john-denny/Speaker-PCB/review/2026-10-24/inner-3v3-plane.png

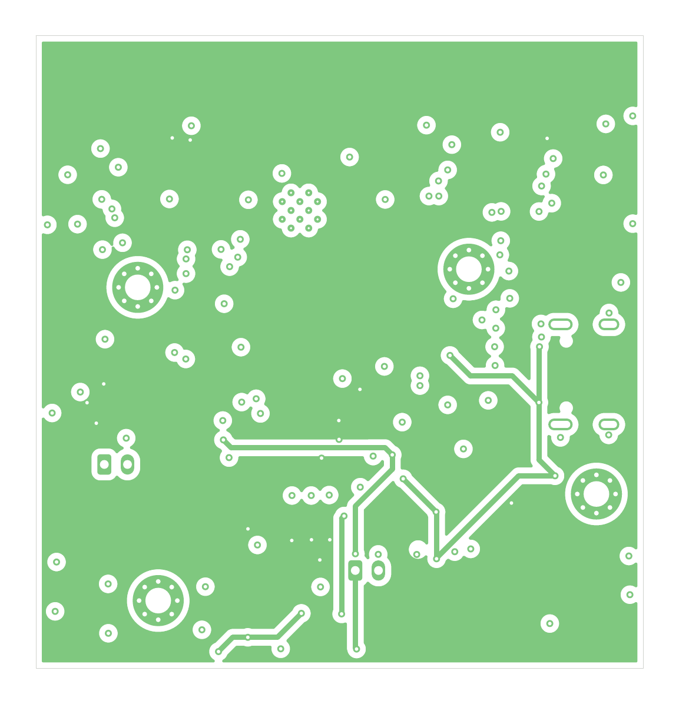
review/2026-10-24/inner-3v3-plane.png
