john-denny/Speaker-PCB/review/2026-10-24/inner-ground-plane.png

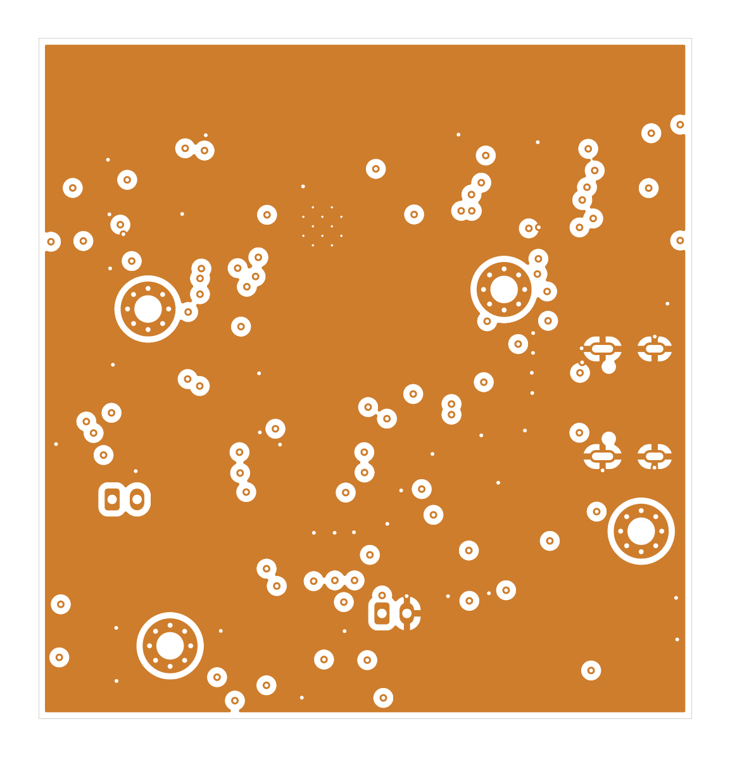
review/2026-10-24/inner-ground-plane.png
