john-denny/Speaker-PCB/review/2026-10-24/top-copper.png

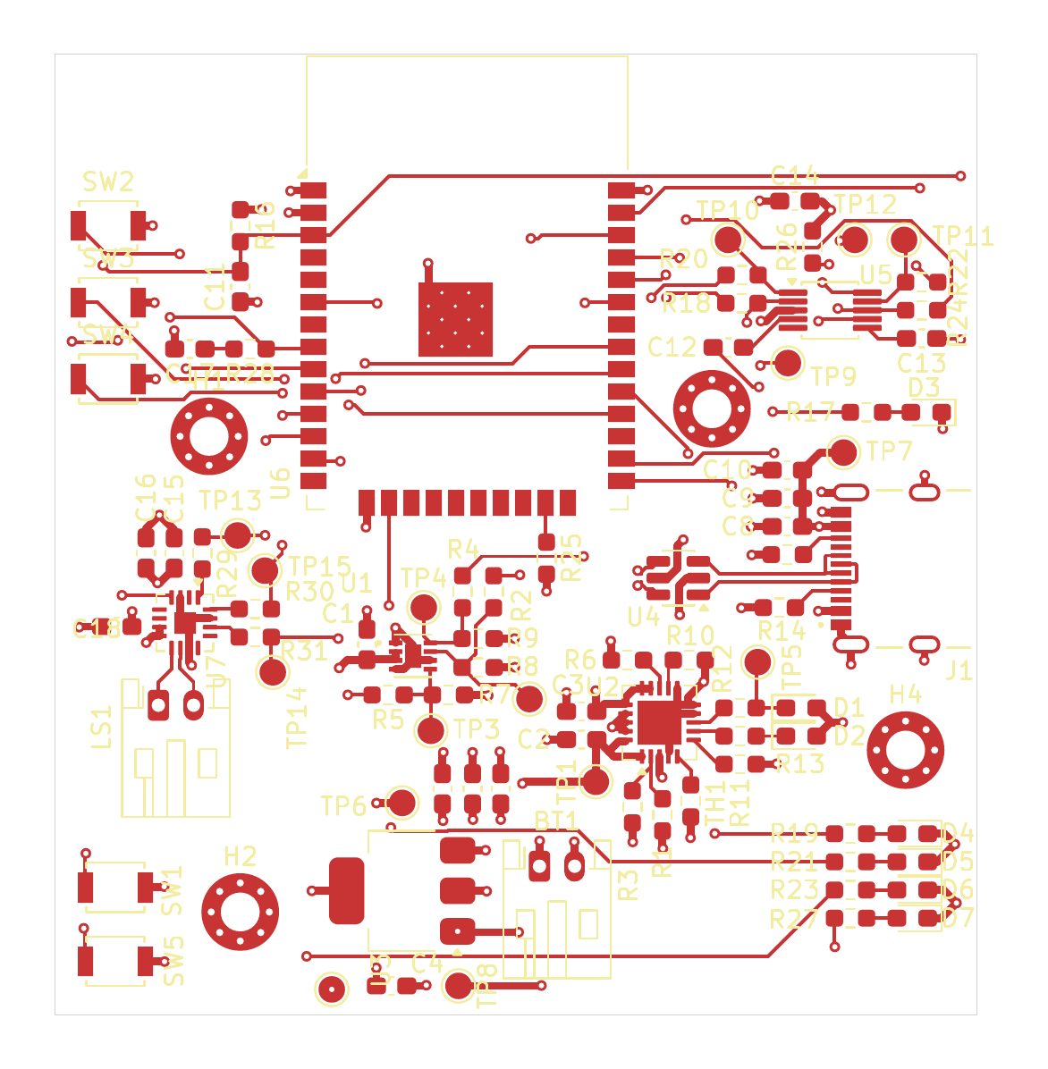
review/2026-10-24/top-copper.png
