john-denny/Speaker-PCB/Speaker.kicad_pcb

## KiCad design Speaker.kicad_pcb (2026-10-24)

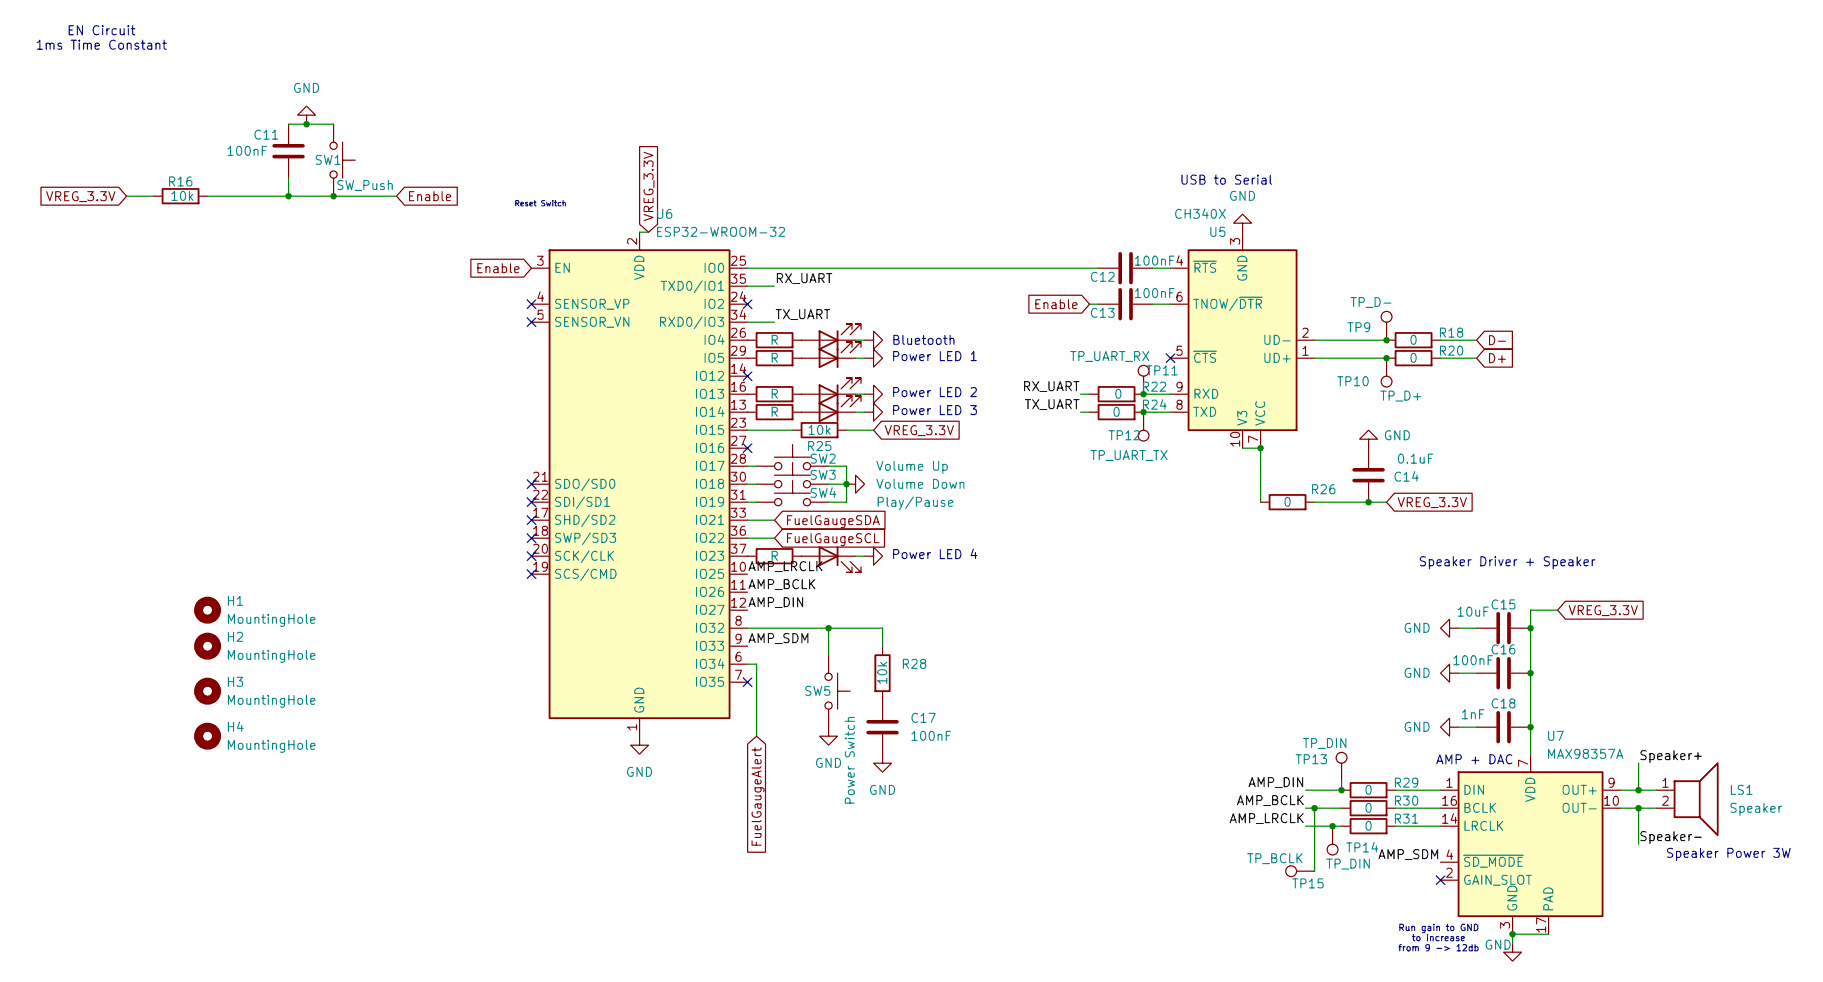
[picture p5: schematic mcu.kicad_sch]

Parts:
C11, C12, C13, C16, C17: 100nF; C_0603_1608Metric_Pad1.08x0.95mm_HandSolder
C14: 0.1uF; C_0603_1608Metric_Pad1.08x0.95mm_HandSolder
C15: 10uF; C_0603_1608Metric_Pad1.08x0.95mm_HandSolder
C18: 1nF; C_0603_1608Metric_Pad1.08x0.95mm_HandSolder
D3, D4, D5, D6, D7: LED; LED_0603_1608Metric_Pad1.05x0.95mm_HandSolder
H1, H2, H3, H4: MountingHole; MountingHole_2.2mm_M2_Pad_Via
LS1: Speaker; JST_PH_S2B-PH-K_1x02_P2.00mm_Horizontal
R16, R25, R28: 10k; R_0603_1608Metric_Pad0.98x0.95mm_HandSolder
R17, R19, R21, R23, R27: R; R_0603_1608Metric_Pad0.98x0.95mm_HandSolder
R18, R20, R22, R24, R26, R29, R30, R31: 0; R_0603_1608Metric_Pad0.98x0.95mm_HandSolder
SW1: SW_Push; SW_SPST_B3U-1000P
SW2: Volume Up; SW_SPST_B3U-1000P
SW3: Volume Down; SW_SPST_B3U-1000P
SW4: Play/Pause; SW_SPST_B3U-1000P
SW5: Power Switch; SW_SPST_B3U-1000P
TP9: TP_D-; TestPoint_Pad_D1.5mm
TP10: TP_D+; TestPoint_Pad_D1.5mm
TP11: TP_UART_RX; TestPoint_Pad_D1.5mm
TP12: TP_UART_TX; TestPoint_Pad_D1.5mm
TP13, TP14: TP_DIN; TestPoint_Pad_D1.5mm
TP15: TP_BCLK; TestPoint_Pad_D1.5mm
U5: CH340X; MSOP-10_3x3mm_P0.5mm
U6: ESP32-WROOM-32
U7: MAX98357A; TQFN-16-1EP_3x3mm_P0.5mm_EP1.23x1.23mm

Connections:
/MCU/AMP_BCLK: R30.1, TP15.1, U6.11 (IO26)
/MCU/AMP_DIN: R29.1, TP13.1, U6.12 (IO27)
/MCU/AMP_LRCLK: R31.1, TP14.1, U6.10 (IO25)
/MCU/AMP_SDM: U6.9 (IO33), U7.4 (~SD_MODE)
/MCU/RX_UART: R22.1, U6.35 (TXD0/IO1)
/MCU/Speaker+: LS1.1, U7.9 (OUT+)
/MCU/Speaker-: LS1.2, U7.10 (OUT-)
/MCU/TX_UART: R24.1, U6.34 (RXD0/IO3)
D+: R20.2; also elsewhere on the board
D-: R18.2; also elsewhere on the board
Enable: C11.2, C13.1, R16.2, SW1.2, U6.3 (EN)
FuelGaugeAlert: U6.6 (IO34); also elsewhere on the board
FuelGaugeSCL: U6.36 (IO22); also elsewhere on the board
FuelGaugeSDA: U6.33 (IO21); also elsewhere on the board
GND: C11.1, C14.1, C15.1, C16.1, C17.2, C18.1, D3.1 (K), D4.1 (K), D5.1 (K), D6.1 (K), D7.1 (K), SW1.1, SW2.2, SW3.2, SW4.2, SW5.2, U5.3 (GND), U6.1 (GND), U6.15 (GND), U6.38 (GND), U6.39 (GND), U7.3 (GND), U7.11 (GND), U7.15 (GND), U7.17 (PAD); also elsewhere on the board
unnamed: C17.1, R28.2
unnamed: D3.2 (A), R17.2
unnamed: D4.2 (A), R19.2
unnamed: D5.2 (A), R21.2
unnamed: D6.2 (A), R23.2
unnamed: D7.2 (A), R27.2
unnamed: R22.2, TP11.1, U5.9 (RXD)
unnamed: C13.2, U5.6 (TNOW/~DTR)
unnamed: R24.2, TP12.1, U5.8 (TXD)
unnamed: R20.1, TP10.1, U5.1 (UD+)
unnamed: R18.1, TP9.1, U5.2 (UD-)
unnamed: R26.1, U5.7 (VCC), U5.10 (V3)
unnamed: C12.2, U5.4 (~RTS)
unnamed: C12.1, U6.25 (IO0)
unnamed: R17.1, U6.26 (IO4)
unnamed: R19.1, U6.29 (IO5)
unnamed: R21.1, U6.16 (IO13)
unnamed: R23.1, U6.13 (IO14)
unnamed: R25.1, U6.23 (IO15)
unnamed: SW2.1, U6.28 (IO17)
unnamed: SW3.1, U6.30 (IO18)
unnamed: SW4.1, U6.31 (IO19)
unnamed: R27.1, U6.37 (IO23)
unnamed: R28.1, SW5.1, U6.8 (IO32)
unnamed: R30.2, U7.16 (BCLK)
unnamed: R29.2, U7.1 (DIN)
unnamed: R31.2, U7.14 (LRCLK)
VREG_3.3V: C14.2, C15.2, C16.2, C18.2, R16.1, R25.2, R26.2, U6.2 (VDD), U7.7 (VDD), U7.8 (VDD); also elsewhere on the board

Notes on the sheet:
AMP + DAC
Reset Switch
Power LED 4
Bluetooth
EN Circuit 1ms Time Constant
Speaker Driver + Speaker
Power LED 3
USB to Serial
Speaker Power 3W
Run gain to GND to increase from 9 -> 12db
Power LED 2
Power LED 1

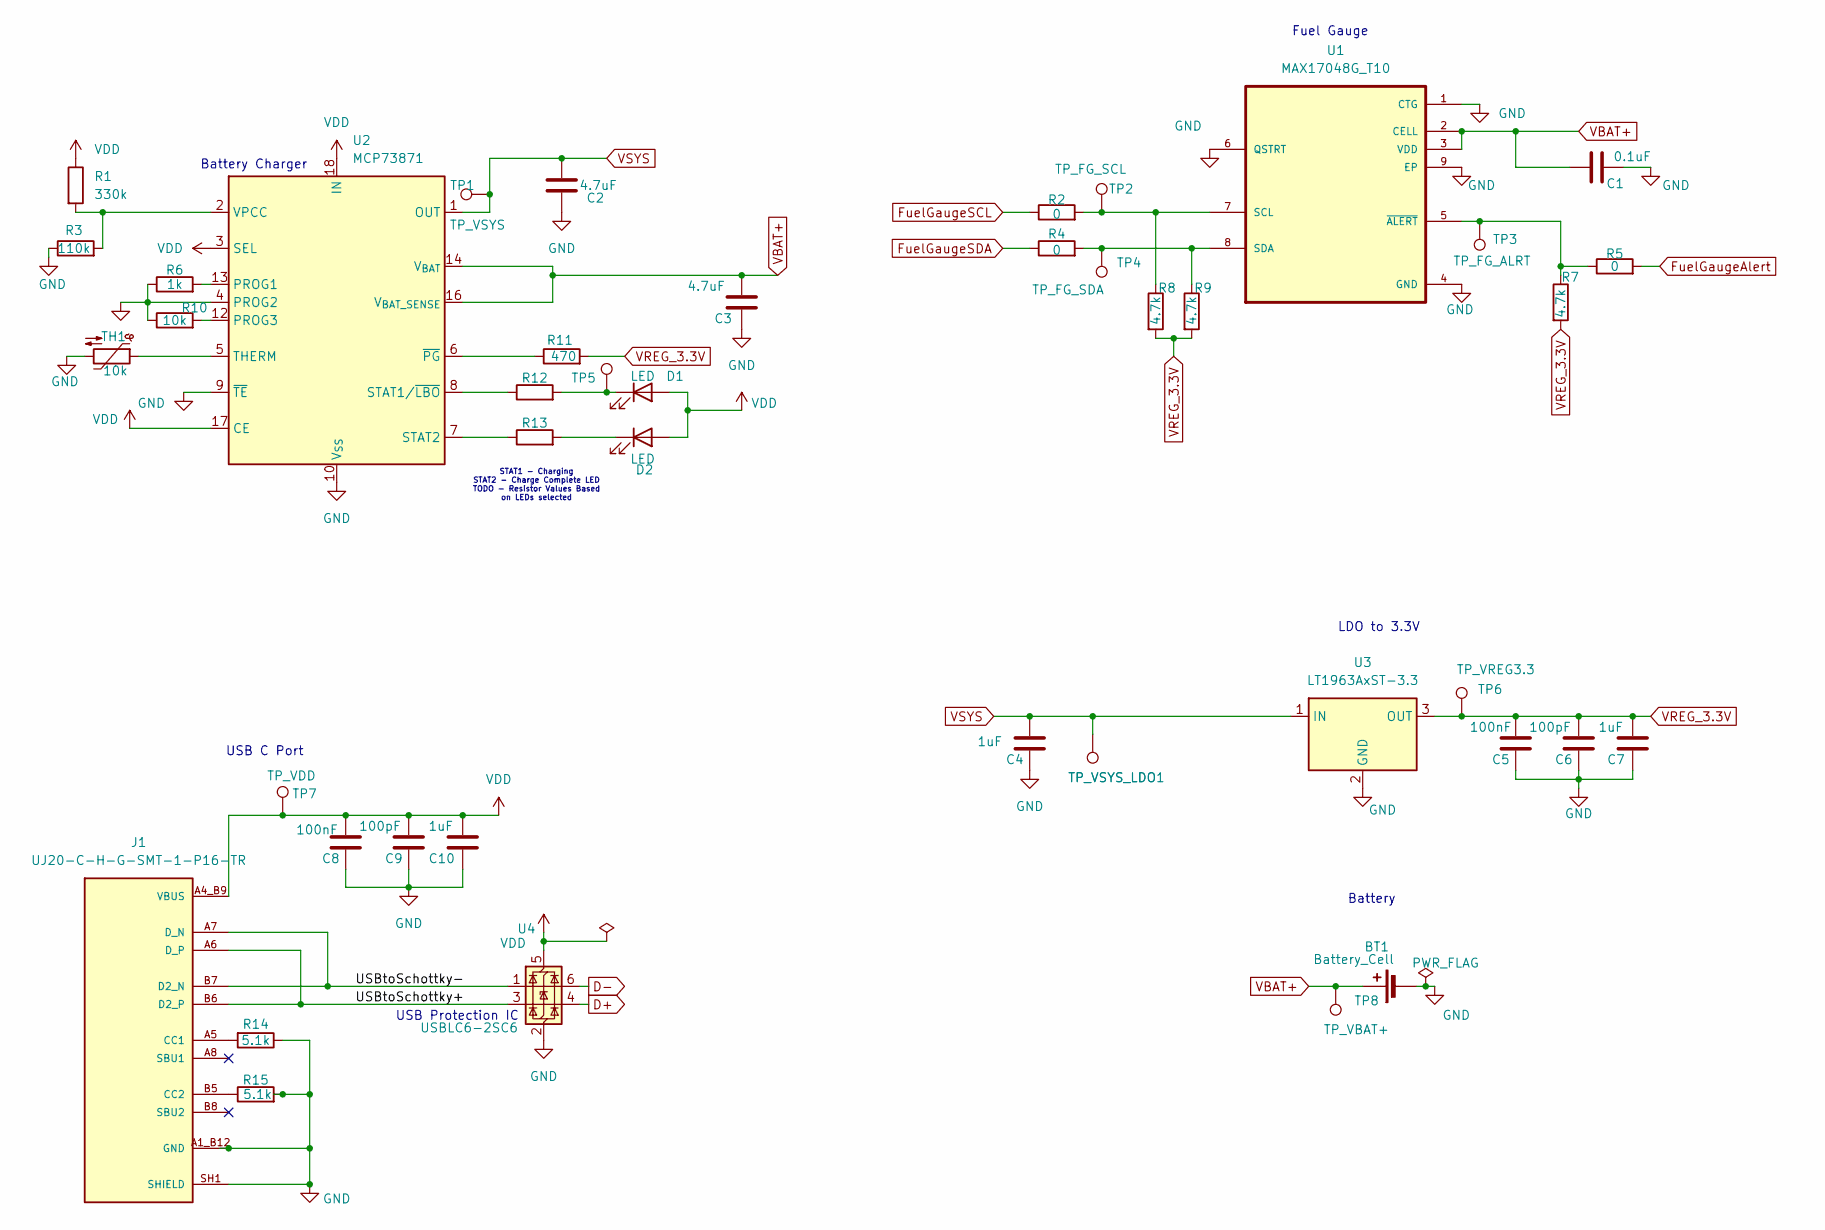
[picture p6: schematic power.kicad_sch]

Parts:
BT1: Battery_Cell; JST_PH_S2B-PH-K_1x02_P2.00mm_Horizontal
C1: 0.1uF; C_0603_1608Metric_Pad1.08x0.95mm_HandSolder
C2, C3: 4.7uF; C_0603_1608Metric_Pad1.08x0.95mm_HandSolder
C4, C7, C10: 1uF; C_0603_1608Metric_Pad1.08x0.95mm_HandSolder
C5, C8: 100nF; C_0603_1608Metric_Pad1.08x0.95mm_HandSolder
C6, C9: 100pF; C_0603_1608Metric_Pad1.08x0.95mm_HandSolder
D1, D2: LED; LED_0603_1608Metric_Pad1.05x0.95mm_HandSolder
J1: UJ20-C-H-G-SMT-1-P16-TR; SAMESKY_UJ20-C-H-G-SMT-1-P16-TR; PARTREV 1.0
R1: 330k; R_0603_1608Metric_Pad0.98x0.95mm_HandSolder
R2, R4, R5: 0; R_0603_1608Metric_Pad0.98x0.95mm_HandSolder
R3: 110k; R_0603_1608Metric_Pad0.98x0.95mm_HandSolder
R6: 1k; R_0603_1608Metric_Pad0.98x0.95mm_HandSolder
R7, R8, R9: 4.7k; R_0603_1608Metric_Pad0.98x0.95mm_HandSolder
R10: 10k; R_0603_1608Metric_Pad0.98x0.95mm_HandSolder
R11: 470; R_0603_1608Metric_Pad0.98x0.95mm_HandSolder
R12, R13: R_0603_1608Metric_Pad0.98x0.95mm_HandSolder
R14, R15: 5.1k; R_0603_1608Metric_Pad0.98x0.95mm_HandSolder
TH1: 10k; R_0603_1608Metric_Pad0.98x0.95mm_HandSolder
TP1: TP_VSYS; TestPoint_Pad_D1.5mm
TP2: TP_FG_SCL; TestPoint_Pad_D1.5mm
TP3: TP_FG_ALRT; TestPoint_Pad_D1.5mm
TP4: TP_FG_SDA; TestPoint_Pad_D1.5mm
TP5: TP_Charging; TestPoint_Pad_D1.5mm
TP6: TP_VREG3.3; TestPoint_Pad_D1.5mm
TP7: TP_VDD; TestPoint_Pad_D1.5mm
TP8: TP_VBAT+; TestPoint_Pad_D1.5mm
TP_VSYS_LDO1: TP_VSYS_LDO; TestPoint_Pad_D1.5mm
U1: MAX17048G_T10; SON50P200X200X80-9N
U2: MCP73871; QFN-20-1EP_4x4mm_P0.5mm_EP2.5x2.5mm
U3: LT1963AxST-3.3; SOT-223-3_TabPin2
U4: USBLC6-2SC6; SOT-23-6

Connections:
/Power/USBtoSchottky+: J1.A6 (D_P), J1.B6 (D2_P), U4.3 (I/O2)
/Power/USBtoSchottky-: J1.A7 (D_N), J1.B7 (D2_N), U4.1 (I/O1)
D+: U4.4 (I/O2); also elsewhere on the board
D-: U4.6 (I/O1); also elsewhere on the board
FuelGaugeAlert: R5.2; also elsewhere on the board
FuelGaugeSCL: R2.1; also elsewhere on the board
FuelGaugeSDA: R4.1; also elsewhere on the board
GND: BT1.2 (-), C1.2, C2.2, C3.2, C4.1, C5.1, C6.1, C7.1, C8.1, C9.1, C10.1, J1.A1_B12 (GND), J1.B1_A12 (GND), J1.SH1 (SHIELD), J1.SH2 (SHIELD), J1.SH3 (SHIELD), J1.SH4 (SHIELD), R3.1, R6.1, R10.1, R14.1, R15.2, TH1.2, U1.1 (CTG), U1.4 (GND), U1.6 (QSTRT), U1.9 (EP), U2.4 (PROG2), U2.9 (~TE), U2.10 (V_{SS}), U2.11 (V_{SS}), U2.21 (V_{SS}), U3.2 (GND), U4.2 (GND); also elsewhere on the board
unnamed: D1.1 (K), R12.2, TP5.1
unnamed: D2.1 (K), R13.2
unnamed: J1.A5 (CC1), R14.2
unnamed: J1.B5 (CC2), R15.1
unnamed: R2.2, R8.1, TP2.1, U1.7 (SCL)
unnamed: R4.2, R9.1, TP4.1, U1.8 (SDA)
unnamed: R5.1, R7.1, TP3.1, U1.5 (~ALERT)
unnamed: R6.2, U2.13 (PROG1)
unnamed: R10.2, U2.12 (PROG3)
unnamed: R12.1, U2.8 (STAT1/~LBO)
unnamed: R13.1, U2.7 (STAT2)
unnamed: TH1.1, U2.5 (THERM)
unnamed: R1.2, R3.2, U2.2 (VPCC)
unnamed: R11.1, U2.6 (~PG)
VBAT+: BT1.1 (+), C1.1, C3.1, TP8.1, U1.2 (CELL), U1.3 (VDD), U2.14 (V_{BAT}), U2.15 (V_{BAT}), U2.16 (V_{BAT_SENSE})
VDD: C8.2, C9.2, C10.2, D1.2 (A), D2.2 (A), J1.A4_B9 (VBUS), J1.B4_A9 (VBUS), R1.1, TP7.1, U2.3 (SEL), U2.17 (CE), U2.18 (IN), U2.19 (IN), U4.5 (VBUS)
VREG_3.3V: C5.2, C6.2, C7.2, R7.2, R8.2, R9.2, R11.2, TP6.1, U3.3 (OUT); also elsewhere on the board
VSYS: C2.1, C4.2, TP1.1, TP_VSYS_LDO1.1, U2.1 (OUT), U2.20 (OUT), U3.1 (IN)

Notes on the sheet:
LDO to 3.3V
Battery
USB C Port
USB Protection IC
Battery Charger
Fuel Gauge
STAT1 - Charging STAT2 - Charge Complete LED TODO - Resistor Values Based on LEDs selected

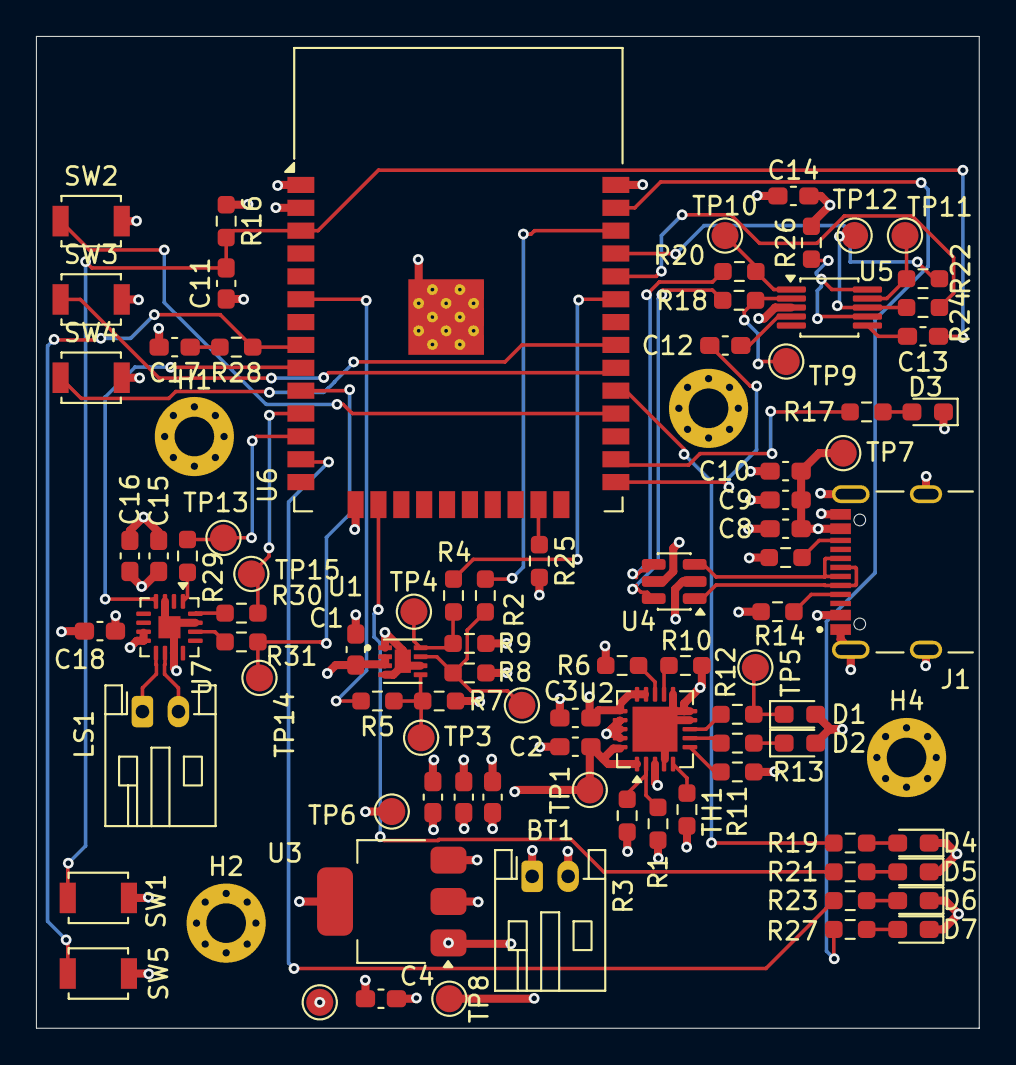
[picture p7: board Speaker.kicad_pcb from above]

Board: 4 copper layers, 52.4 x 55.1 mm, 92 parts (0 on the bottom side), 62 nets.
