john-denny/Speaker-PCB/(commit log)

2026-08-29 Update USB C port and Charger to match App notes
2026-08-30 Finish power sheet
2026-09-04 Put component families together on PCB
2026-09-04 PCB Design before inter-family routing
2026-09-04 Board shape setup
2026-09-11 Update speaker PCB design
2026-10-24 Mostly finished schematic and pcb, getting codex to review it now
